qamil95/avr_set_route/Dokumentacja/Lista_elementów.pdf

L.P. | Oznaczenie | Nazwa elementu | Wartość | Ilość | Uwagi | Cena (szt) | Cena (całk)
1 | ATMEGA16A | Procesor | - | 1 | obudowa DIP, przewlekana | 12,90 zł | 12,90 zł
2 | LEDxx | Dioda LED | - | 49 | zielona, 5mm | 0,15 zł | 7,35 zł
3 | Dx | Wyświetlacz 7-segmentowy | - | 5 | wspólna anoda | 0,90 zł | 4,50 zł
4 | 7805 | Stabilizator napięcia | - | 1 | L7805CV | 0,90 zł | 0,90 zł
5 | KBU6M | Mostek prostowniczy | - | 1 | | 1,25 zł | 1,25 zł
6 | C6, C7 | Kondensator | 47uF | 2 | elektrolityczny | 0,30 zł | 0,60 zł
7 | C1-C5 | Kondensator | 100nF | 5 | ceramiczny | 0,10 zł | 0,50 zł
8 | Rxx | Rezystor | 330Ω | 14 | | 0,06 zł | 0,89 zł
9 | Rxx | Rezystor | 10kΩ | 27 | | 0,06 zł | 1,71 zł
10 | 2N3906 | Tranzystor PNP | - | 12 | | 0,20 zł | 2,38 zł
11 | BC547 | Tranzystor NPN | - | 14 | | 0,20 zł | 2,77 zł
12 | Sx | Przełącznik dźwigniowy | - | 9 | | 1,50 zł | 13,50 zł
13 | - | Płytka uniwersalna | - | 2 | | 6,50 zł | 13,00 zł
14 | - | Złącze goldpin | - | 1 | | 1,20 zł | 1,20 zł
Suma | | | | | | | 63,44 zł
