qamil95/avr_set_route/Dokumentacja/Dane_katalogowe/06438_LCD_7segment.pdf

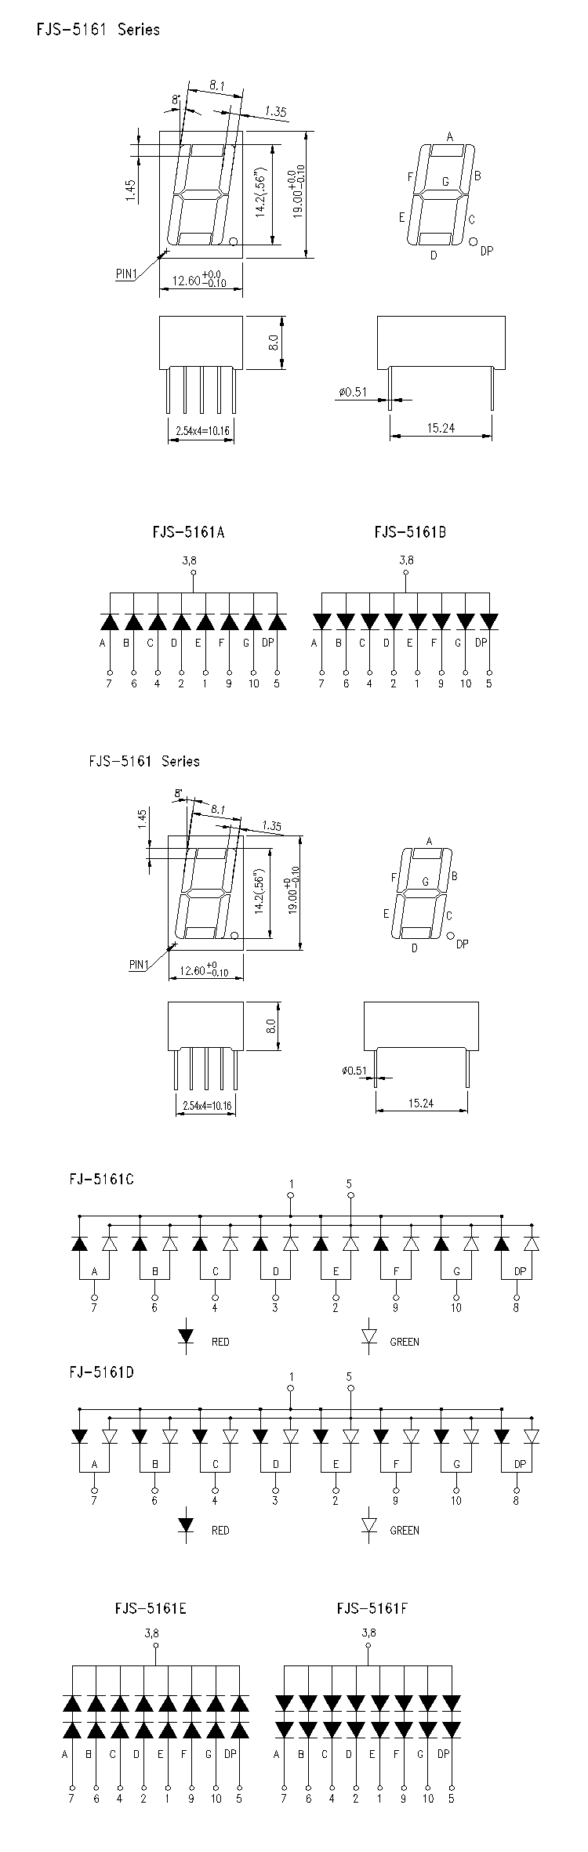
[picture p24: page 1]
