qamil95/avr_set_route/Hardware/PDF/płytka_pcb.pdf

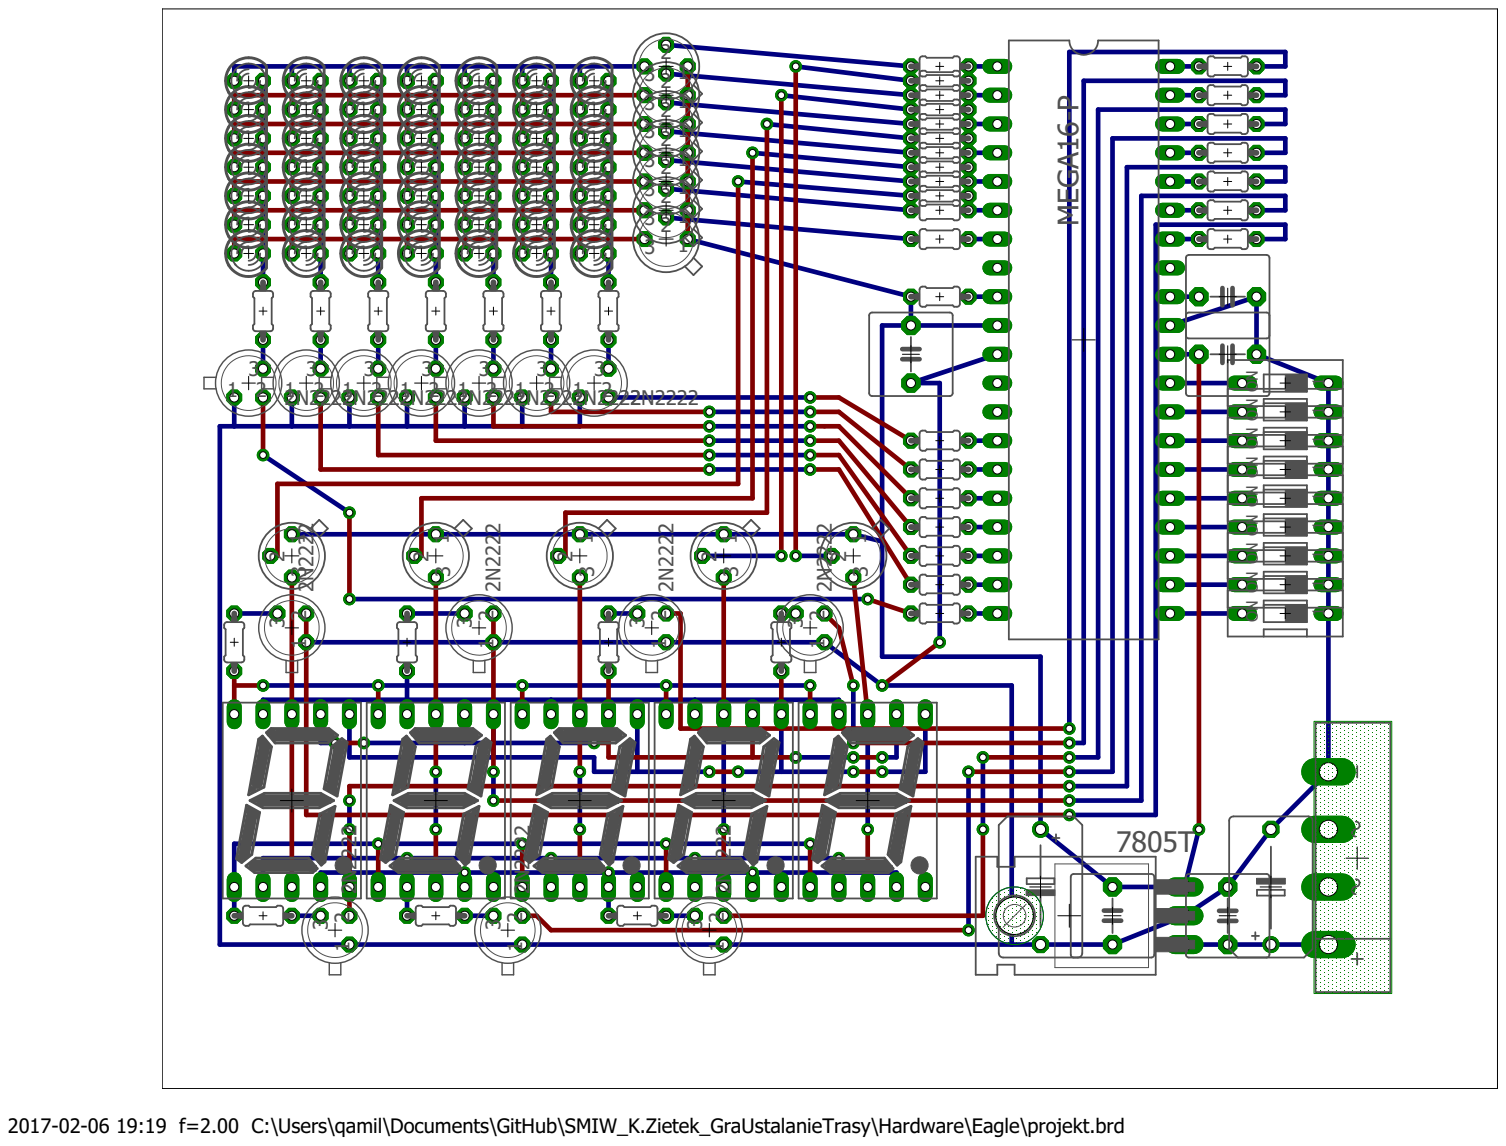
[picture p25: page 1]

2017-02-06 19:19 f=2.00 C:\Users\qamil\Documents\GitHub\SMIW_K.Zietek_GraUstalanieTrasy\Hardware\Eagle\projekt.brd
