qamil95/avr_set_route/Hardware/PDF/schemat_ideowy.pdf

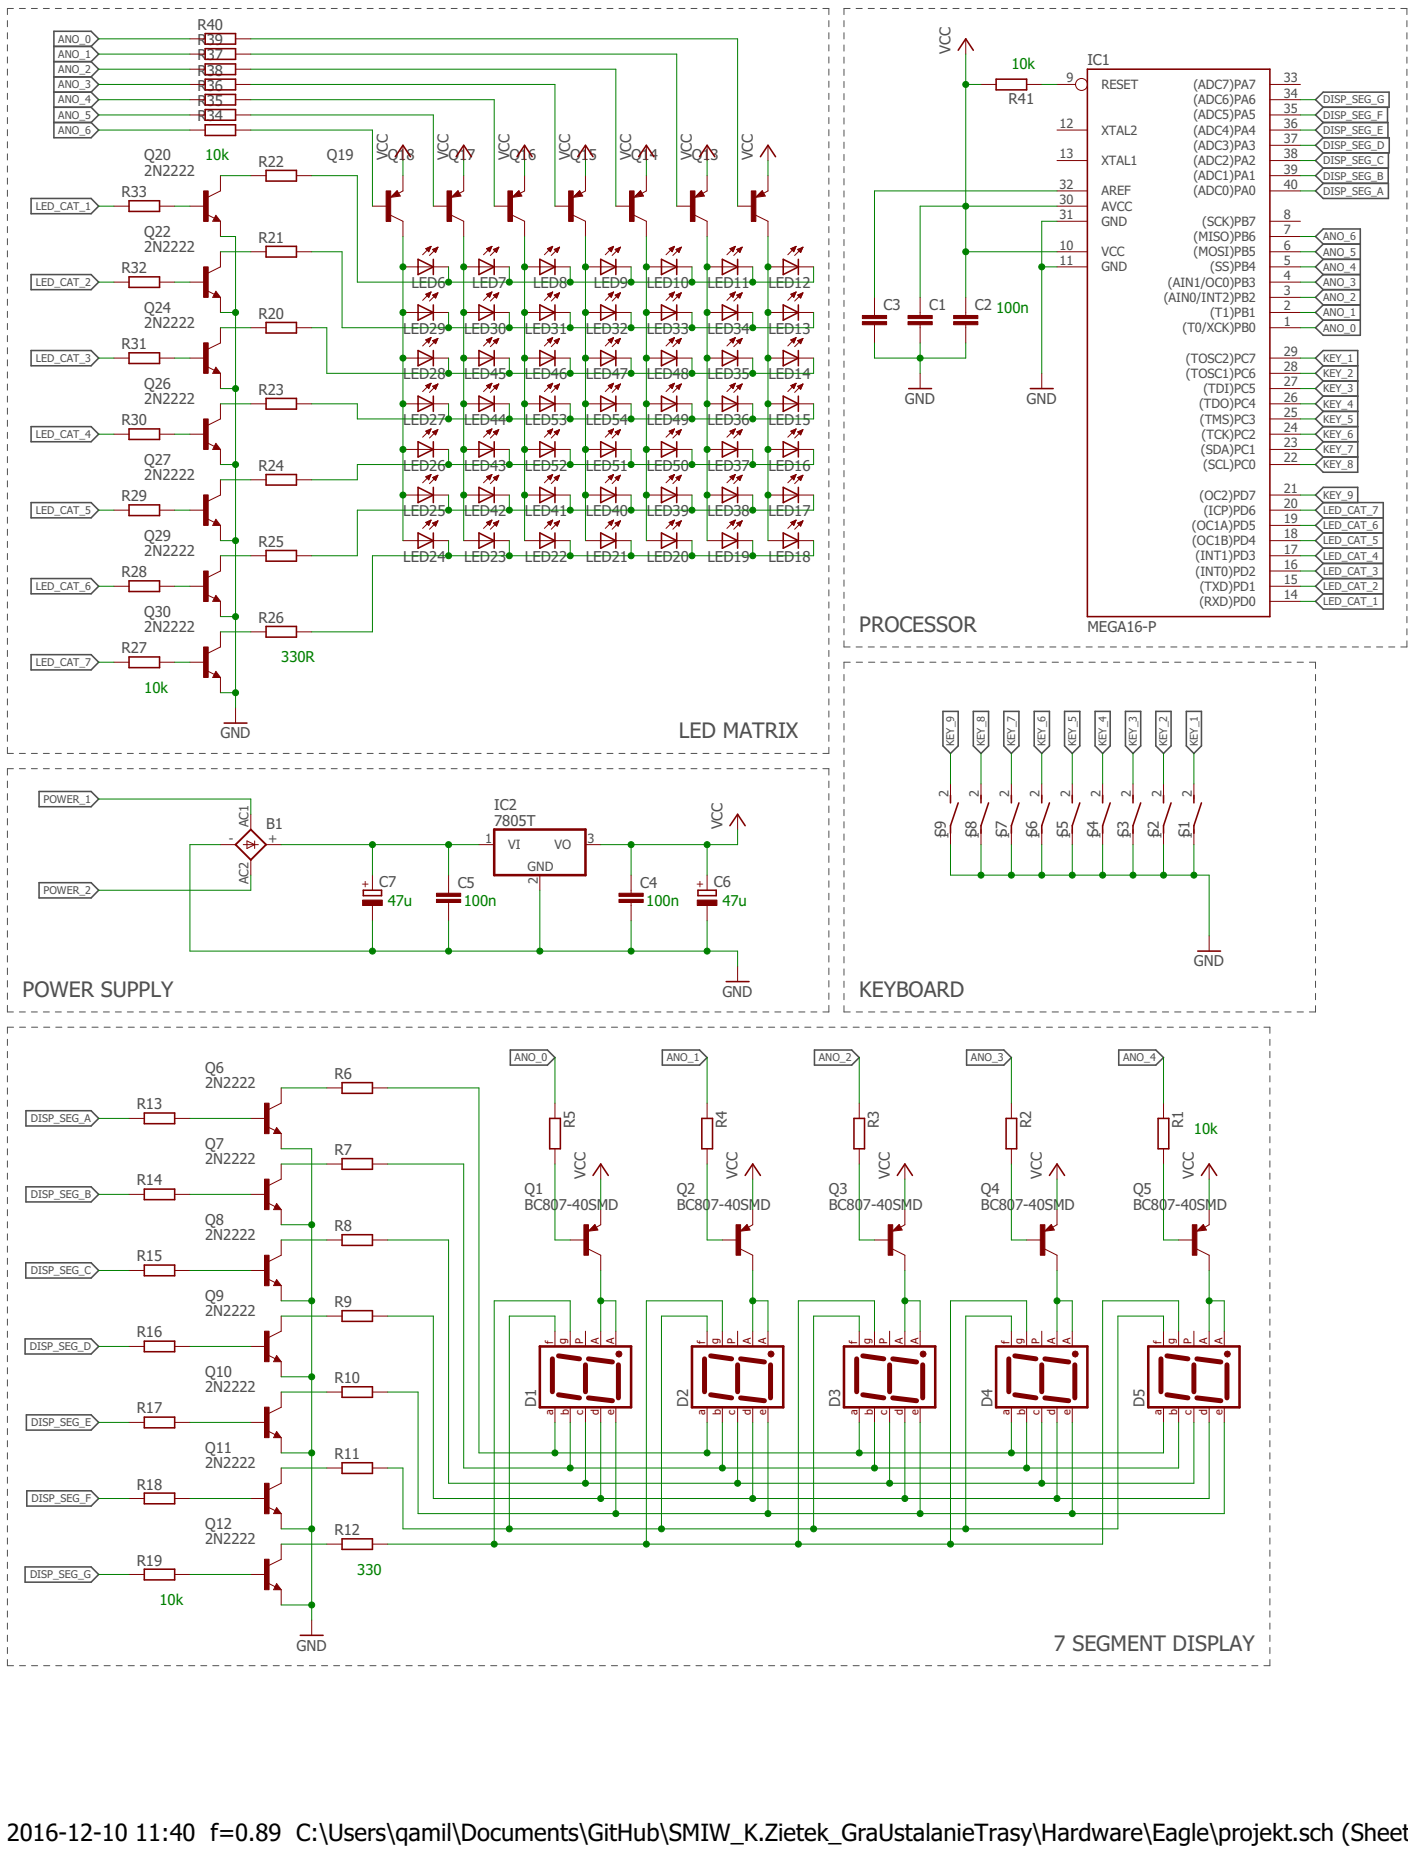
[picture p26: page 1]

2016-12-10 11:40 f=0.89 C:\Users\qamil\Documents\GitHub\SMIW_K.Zietek_GraUstalanieTrasy\Hardware\Eagle\projekt.sch (Sheet: 1/1)
