qamil95/avr_set_route/Hardware/Eagle/projekt.brd

## EAGLE design Hardware/Eagle/projekt.brd (2017-02-07)

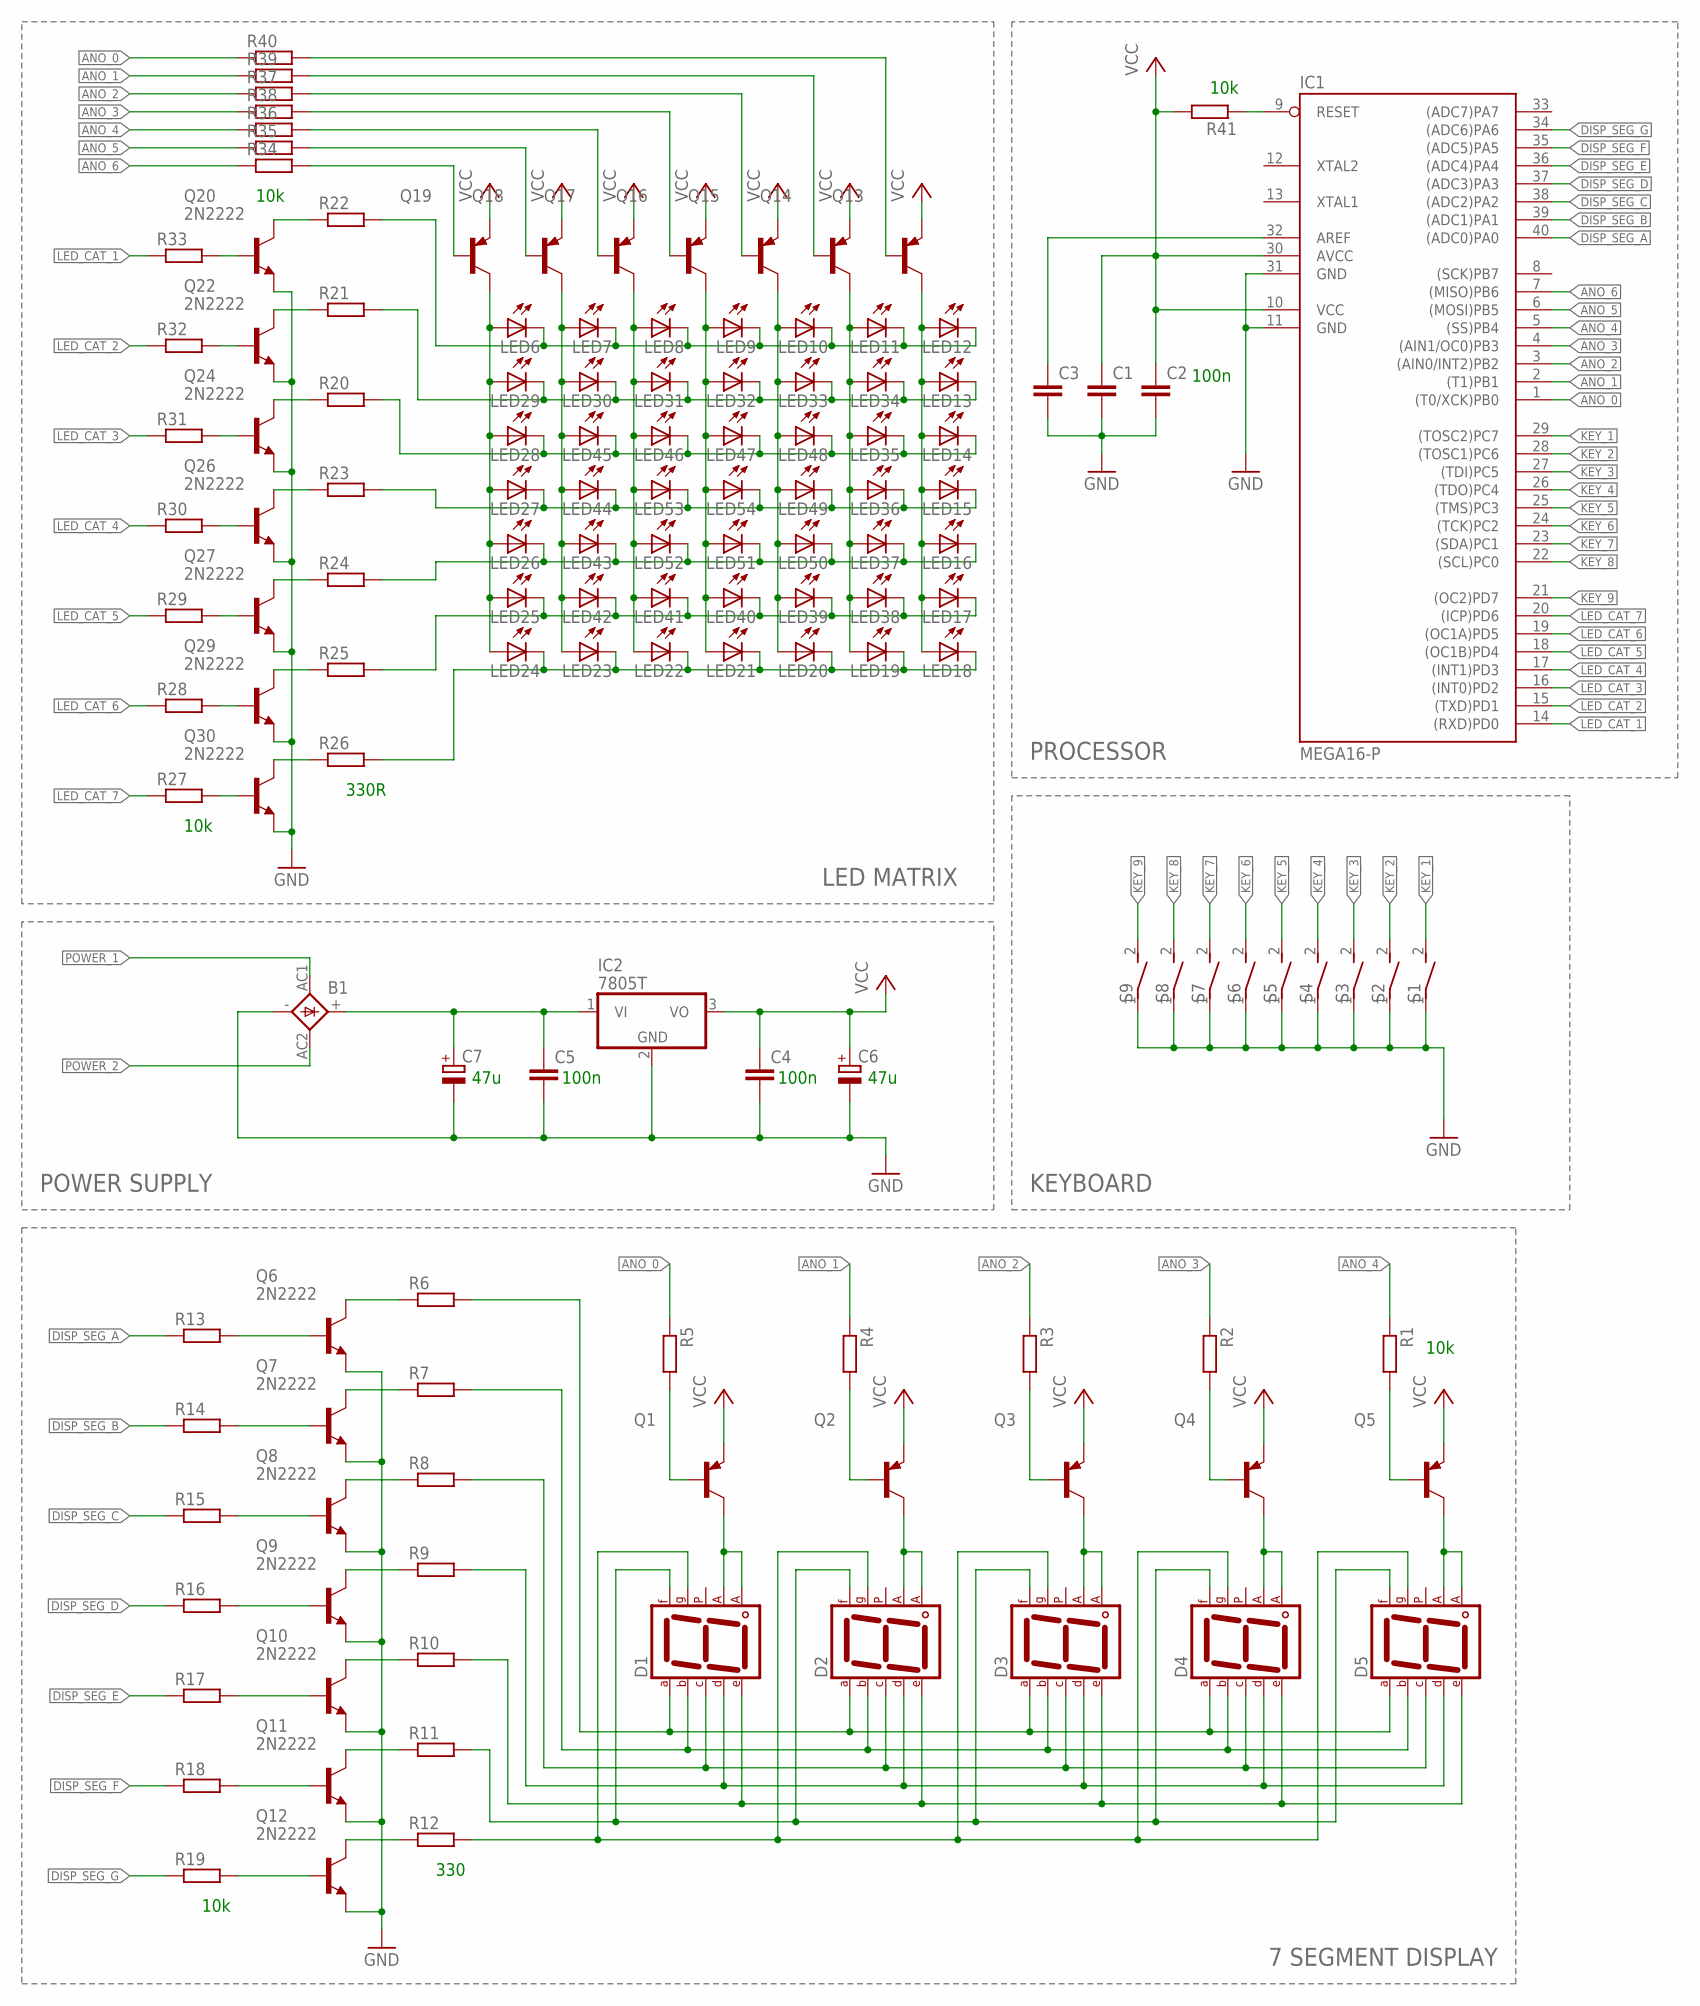
[picture p27: schematic projekt.sch]

Parts:
B1: KBU
C1, C2, C3, C4, C5: C5/7.2; C5B7.2
C6, C7: CPOL-EUB45181C; B45181C
D1, D2, D3, D4, D5: 7SEG-CA; 7SEG-13
IC1: MEGA16-P; DIL40
IC2: 7805T; TO220H
LED6, LED7, LED8, LED9, LED10, LED11, LED12, LED13, LED14, LED15, LED16, LED17, LED18, LED19, LED20, LED21, LED22, LED23, LED24, LED25, LED26, LED27, LED28, LED29, LED30, LED31, LED32, LED33, LED34, LED35, LED36, LED37, LED38, LED39, LED40, LED41, LED42, LED43, LED44, LED45, LED46, LED47, LED48, LED49, LED50, LED51, LED52, LED53, LED54: LED3MM
Q1, Q2, Q3, Q4, Q5, Q13, Q14, Q15, Q16, Q17, Q18, Q19: -PNP-TO18-; TO18-
Q6, Q7, Q8, Q9, Q10, Q11, Q12, Q20, Q22, Q24, Q26, Q27, Q29, Q30: 2N2222; TO18
R1, R2, R3, R4, R5, R6, R7, R8, R9, R10, R11, R12, R13, R14, R15, R16, R17, R18, R19, R20, R21, R22, R23, R24, R25, R26, R27, R28, R29, R30, R31, R32, R33, R34, R35, R36, R37, R38, R39, R40, R41: R-EU_0204/5; 0204/5
S1, S2, S3, S4, S5, S6, S7, S8, S9: DS01E; DS-01

Connections:
ANO_0: IC1.1 ((T0/XCK)PB0), R5.1, R40.1
ANO_1: IC1.2 ((T1)PB1), R4.1, R39.1
ANO_2: IC1.3 ((AIN0/INT2)PB2), R3.1, R37.1
ANO_3: IC1.4 ((AIN1/OC0)PB3), R2.1, R38.1
ANO_4: IC1.5 ((SS)PB4), R1.1, R36.1
ANO_5: IC1.6 ((MOSI)PB5), R35.1
ANO_6: IC1.7 ((MISO)PB6), R34.1
DISP_SEG_A: IC1.40 ((ADC0)PA0), R13.1
DISP_SEG_B: IC1.39 ((ADC1)PA1), R14.1
DISP_SEG_C: IC1.38 ((ADC2)PA2), R15.1
DISP_SEG_D: IC1.37 ((ADC3)PA3), R16.1
DISP_SEG_E: IC1.36 ((ADC4)PA4), R17.1
DISP_SEG_F: IC1.35 ((ADC5)PA5), R18.1
DISP_SEG_G: IC1.34 ((ADC6)PA6), R19.1
GND: B1.-, C1.2, C2.2, C3.2, C4.2, C5.2, C6.-, C7.-, IC1.11 (GND), IC1.31 (GND), IC2.2 (GND), Q6.1 (E), Q7.1 (E), Q8.1 (E), Q9.1 (E), Q10.1 (E), Q11.1 (E), Q12.1 (E), Q20.1 (E), Q22.1 (E), Q24.1 (E), Q26.1 (E), Q27.1 (E), Q29.1 (E), Q30.1 (E), S1.1, S2.1, S3.1, S4.1, S5.1, S6.1, S7.1, S8.1, S9.1
KEY_1: IC1.29 ((TOSC2)PC7), S1.2
KEY_2: IC1.28 ((TOSC1)PC6), S2.2
KEY_3: IC1.27 ((TDI)PC5), S3.2
KEY_4: IC1.26 ((TDO)PC4), S4.2
KEY_5: IC1.25 ((TMS)PC3), S5.2
KEY_6: IC1.24 ((TCK)PC2), S6.2
KEY_7: IC1.23 ((SDA)PC1), S7.2
KEY_8: IC1.22 ((SCL)PC0), S8.2
KEY_9: IC1.21 ((OC2)PD7), S9.2
LED_CAT_1: IC1.14 ((RXD)PD0), R33.1
LED_CAT_2: IC1.15 ((TXD)PD1), R32.1
LED_CAT_3: IC1.16 ((INT0)PD2), R31.1
LED_CAT_4: IC1.17 ((INT1)PD3), R30.1
LED_CAT_5: IC1.18 ((OC1B)PD4), R29.1
LED_CAT_6: IC1.19 ((OC1A)PD5), R28.1
LED_CAT_7: IC1.20 ((ICP)PD6), R27.1
unnamed: D1.7 (A), D2.7 (A), D3.7 (A), D4.7 (A), D5.7 (A), R6.2
unnamed: D1.6 (B), D2.6 (B), D3.6 (B), D4.6 (B), D5.6 (B), R7.2
unnamed: D1.4 (C), D2.4 (C), D3.4 (C), D4.4 (C), D5.4 (C), R8.2
unnamed: D1.2 (D), D2.2 (D), D3.2 (D), D4.2 (D), D5.2 (D), R9.2
unnamed: D1.1 (E), D2.1 (E), D3.1 (E), D4.1 (E), D5.1 (E), R10.2
unnamed: D1.9 (F), D2.9 (F), D3.9 (F), D4.9 (F), D5.9 (F), R11.2
unnamed: D1.3 (CA1), D1.8 (CA2), Q1.3 (C)
unnamed: D2.3 (CA1), D2.8 (CA2), Q2.3 (C)
unnamed: D3.3 (CA1), D3.8 (CA2), Q3.3 (C)
unnamed: D4.3 (CA1), D4.8 (CA2), Q4.3 (C)
unnamed: D5.3 (CA1), D5.8 (CA2), Q5.3 (C)
unnamed: Q1.2 (B), R5.2
unnamed: Q2.2 (B), R4.2
unnamed: Q3.2 (B), R3.2
unnamed: Q4.2 (B), R2.2
unnamed: Q5.2 (B), R1.2
unnamed: Q6.3 (C), R6.1
unnamed: Q7.3 (C), R7.1
unnamed: Q8.3 (C), R8.1
unnamed: Q9.3 (C), R9.1
unnamed: Q10.3 (C), R10.1
unnamed: Q11.3 (C), R11.1
unnamed: Q12.3 (C), R12.1
unnamed: D1.10 (G), D2.10 (G), D3.10 (G), D4.10 (G), D5.10 (G), R12.2
unnamed: B1.+, C5.1, C7.+, IC2.1 (VI)
unnamed: Q8.2 (B), R15.2
unnamed: Q9.2 (B), R16.2
unnamed: Q10.2 (B), R17.2
unnamed: Q11.2 (B), R18.2
unnamed: Q7.2 (B), R14.2
unnamed: Q6.2 (B), R13.2
unnamed: Q12.2 (B), R19.2
unnamed: LED13.K (C), LED29.K (C), LED30.K (C), LED31.K (C), LED32.K (C), LED33.K (C), LED34.K (C), R21.2
unnamed: LED14.K (C), LED28.K (C), LED35.K (C), LED45.K (C), LED46.K (C), LED47.K (C), LED48.K (C), R20.2
unnamed: LED15.K (C), LED27.K (C), LED36.K (C), LED44.K (C), LED49.K (C), LED53.K (C), LED54.K (C), R23.2
unnamed: LED16.K (C), LED26.K (C), LED37.K (C), LED43.K (C), LED50.K (C), LED51.K (C), LED52.K (C), R24.2
unnamed: LED17.K (C), LED25.K (C), LED38.K (C), LED39.K (C), LED40.K (C), LED41.K (C), LED42.K (C), R25.2
unnamed: LED18.K (C), LED19.K (C), LED20.K (C), LED21.K (C), LED22.K (C), LED23.K (C), LED24.K (C), R26.2
unnamed: LED6.A, LED24.A, LED25.A, LED26.A, LED27.A, LED28.A, LED29.A, Q19.3 (C)
unnamed: LED7.A, LED23.A, LED30.A, LED42.A, LED43.A, LED44.A, LED45.A, Q18.3 (C)
unnamed: LED8.A, LED22.A, LED31.A, LED41.A, LED46.A, LED52.A, LED53.A, Q17.3 (C)
unnamed: LED9.A, LED21.A, LED32.A, LED40.A, LED47.A, LED51.A, LED54.A, Q16.3 (C)
unnamed: LED10.A, LED20.A, LED33.A, LED39.A, LED48.A, LED49.A, LED50.A, Q15.3 (C)
unnamed: LED11.A, LED19.A, LED34.A, LED35.A, LED36.A, LED37.A, LED38.A, Q14.3 (C)
unnamed: LED12.A, LED13.A, LED14.A, LED15.A, LED16.A, LED17.A, LED18.A, Q13.3 (C)
unnamed: Q30.3 (C), R26.1
unnamed: LED6.K (C), LED7.K (C), LED8.K (C), LED9.K (C), LED10.K (C), LED11.K (C), LED12.K (C), R22.2
unnamed: Q13.2 (B), R40.2
unnamed: Q29.3 (C), R25.1
unnamed: Q27.3 (C), R24.1
unnamed: Q26.3 (C), R23.1
unnamed: Q24.3 (C), R20.1
unnamed: Q22.3 (C), R21.1
unnamed: Q20.3 (C), R22.1
unnamed: Q20.2 (B), R33.2
unnamed: Q22.2 (B), R32.2
unnamed: Q26.2 (B), R30.2
unnamed: Q24.2 (B), R31.2
unnamed: Q27.2 (B), R29.2
unnamed: Q29.2 (B), R28.2
unnamed: Q30.2 (B), R27.2
unnamed: Q18.2 (B), R35.2
unnamed: Q17.2 (B), R36.2
unnamed: Q15.2 (B), R37.2
unnamed: Q19.2 (B), R34.2
unnamed: Q16.2 (B), R38.2
unnamed: Q14.2 (B), R39.2
unnamed: IC1.9 (RESET), R41.1
unnamed: C3.1, IC1.32 (AREF)
POWER_1: B1.AC1
POWER_2: B1.AC2
VCC: C1.1, C2.1, C4.1, C6.+, IC1.10 (VCC), IC1.30 (AVCC), IC2.3 (VO), Q1.1 (E), Q2.1 (E), Q3.1 (E), Q4.1 (E), Q5.1 (E), Q13.1 (E), Q14.1 (E), Q15.1 (E), Q16.1 (E), Q17.1 (E), Q18.1 (E), Q19.1 (E), R41.2

Notes on the sheet:
10k
330
330R
100n
KEYBOARD
POWER SUPPLY
47u
7 SEGMENT DISPLAY
PROCESSOR
LED MATRIX

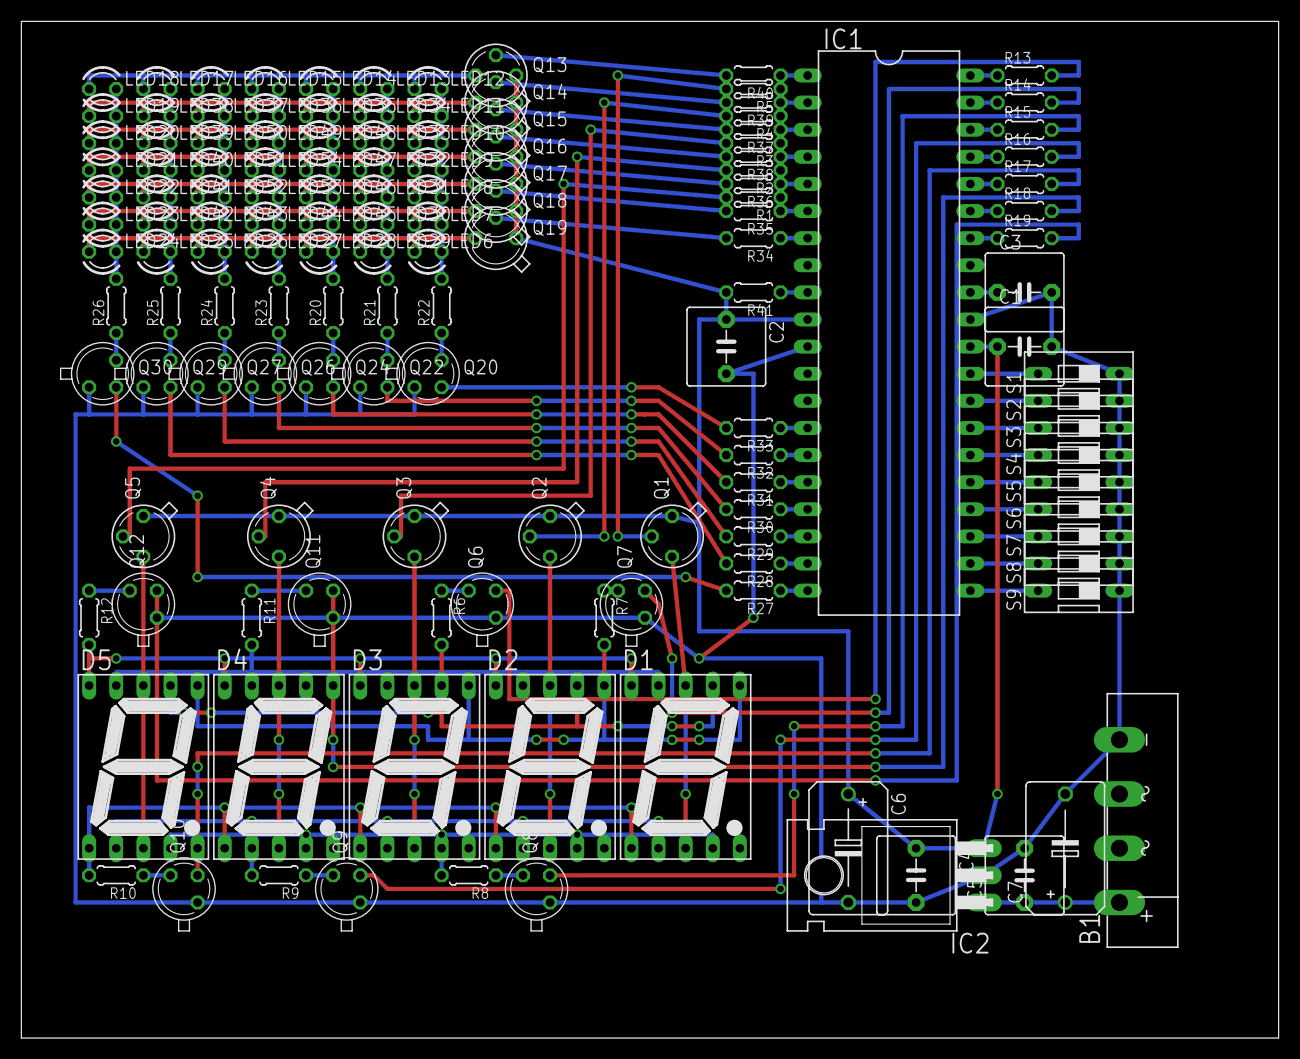
[picture p28: board projekt.brd from above]

Board: 2 copper layers, 117.8 x 95.2 mm, 140 parts (0 on the bottom side), 101 nets.
