qamil95/avr_set_route/(commit log)

2016-11-16 aktualizacja schematu
    [projekt.sch]
2016-11-17 pierwsza wersja zasilania
    [projekt.sch]
2016-11-23 aktualizacja danych katalogowych - kupione czesci
    [projekt.sch]
2016-11-25 generalne porzadki w kodzie i schemacie
    [projekt.sch]
2016-11-30 diody i klawiatura
    [projekt.sch]
2016-12-06 multiplekser zamiast klawiatury matrycowej
    [projekt.sch]
2016-12-08 przerwania, multiplekser
    [projekt.sch]
2016-12-10 wymiana klawiatury
    [projekt.sch]
2017-02-03 gaszeniei zapalanie ledow
